DavidMS51/xmas15-project/README.md

# WordClock
Info on how I created a simple PiZero WordClock

IMPORTANT,  

The files and information here relate the to oringinal stripboard version. 
In developing the Kickstarter version a number of changes were made to IO usage and components. 
The s/w here will NOT work on the Kickstarter board correctly. 
The reverse is also true - ie the Kickstarter s/w downloads will NOT work on hardward built to the schematic in this folder

This is offered for example only, use at your own risk
