DavidMS51/xmas15-project/8x8r1.pdf

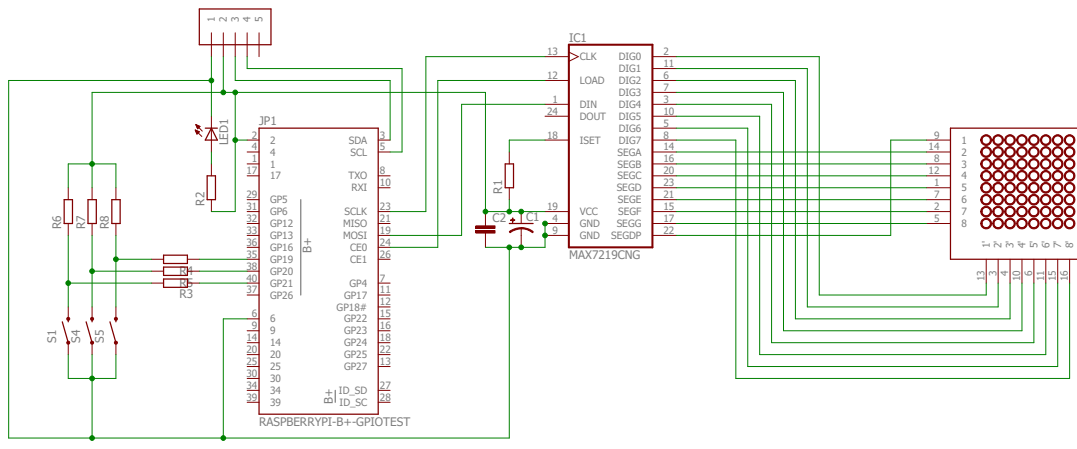
[picture p1: page 1]
MAX7219CNG; RASPBERRYPI-B+-GPIOTEST; DIG2; DIG3; DIG4; DIG5; DIG6; DIG7; SEGA; SEGB; SEGC; SEGD; SEGE; SEGF; SEGG; SEGDP; DIG1; 11 DIG0; DIN 1 DOUT 24; LOAD 12; CLK 13; ISET 18; GND 9; GND 4; VCC 19 1 1; SDA; SCL; MOSI; 19 MISO; 21 SCLK; RXI; 10 TXO; C1 R¹ R² LED¹ S1; R5 R⁶R⁷R⁸ S4S5
