DavidMS51/xmas15-project/8x8r1.sch

## EAGLE design 8x8r1.sch (2016-01-15, last stored version)

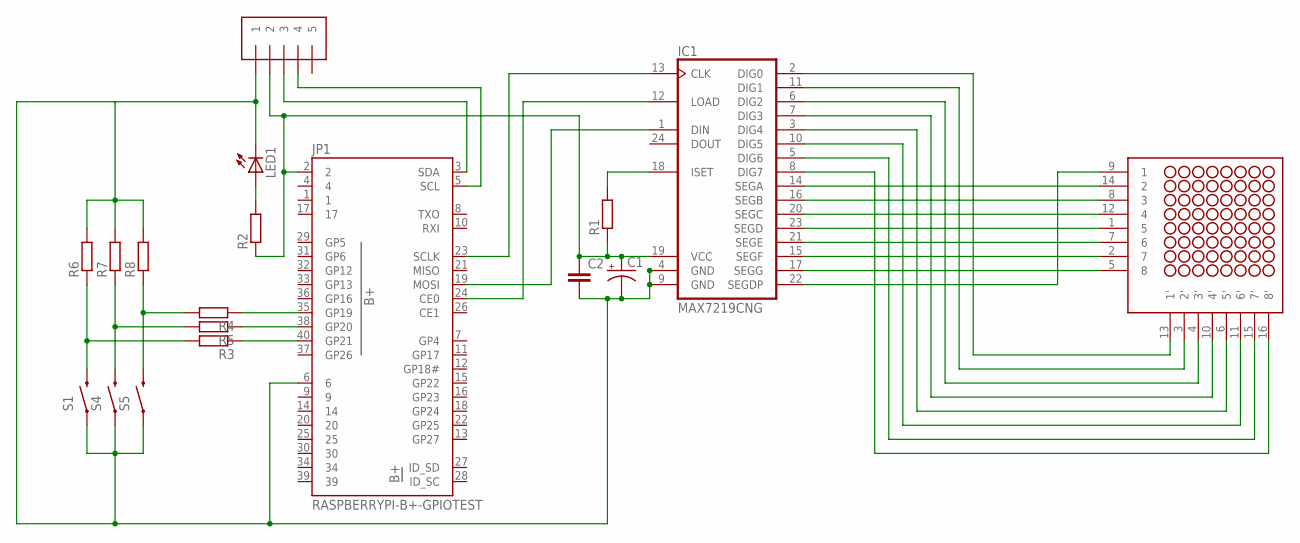
[picture p2: schematic 8x8r1.sch]

Parts:
C1: CPOL-USE2.5-7; E2,5-7
C2: C-EU025-024X044; C025-024X044
IC1: MAX7219CNG; DIL24-3
J1: 1X5; 1X05-3.5MM
JP1: RASPBERRYPI-B+-GPIOTEST; 2X20-SHROUDED
LED1: LED3MM
R1, R2, R3, R4, R5, R6, R7, R8: R-EU_0204/7; 0204/7
S1, S4, S5: SPARKFUN-ELECTROMECHANICAL_SWITCH-MOMENTARY-2PTH; SPARKFUN-ELECTROMECHANICAL_TACTILE-PTH
U$1: NFM-12881BG-11

Connections:
unnamed: IC1.2 (DIG0), U$1.13 (1')
unnamed: IC1.11 (DIG1), U$1.3 (2')
unnamed: IC1.6 (DIG2), U$1.4 (3')
unnamed: IC1.7 (DIG3), U$1.10 (4')
unnamed: IC1.3 (DIG4), U$1.6 (5')
unnamed: IC1.10 (DIG5), U$1.11 (6')
unnamed: IC1.5 (DIG6), U$1.15 (7')
unnamed: IC1.8 (DIG7), U$1.16 (8')
unnamed: IC1.17 (SEGG), U$1.5 (8)
unnamed: IC1.15 (SEGF), U$1.2 (7)
unnamed: IC1.21 (SEGE), U$1.7 (6)
unnamed: IC1.23 (SEGD), U$1.1 (5)
unnamed: IC1.20 (SEGC), U$1.12 (4)
unnamed: IC1.16 (SEGB), U$1.8 (3)
unnamed: IC1.14 (SEGA), U$1.14 (2)
unnamed: IC1.22 (SEGDP), U$1.9 (1)
unnamed: C1.+, C2.1, IC1.19 (VCC), J1.2, JP1.2, R1.1, R2.1
unnamed: IC1.18 (ISET), R1.2
unnamed: IC1.12 (LOAD), JP1.24 (CE0)
unnamed: IC1.1 (DIN), JP1.19 (MOSI)
unnamed: IC1.13 (CLK), JP1.23 (SCLK)
unnamed: LED1.A, R2.2
unnamed: JP1.35 (GP19), R4.1
unnamed: J1.3, JP1.3 (SDA)
unnamed: J1.4, JP1.5 (SCL)
unnamed: JP1.38 (GP20), R5.1
unnamed: JP1.40 (GP21), R3.1
unnamed: R4.2, R8.1, S5.3 (2)
unnamed: R5.2, R7.1, S4.3 (2)
unnamed: R3.2, R6.1, S1.3 (2)
unnamed: C1.-, C2.2, IC1.4 (GND), IC1.9 (GND), J1.1, JP1.6, LED1.K (C), R6.2, R7.2, R8.2, S1.1, S4.1, S5.1
