DavidMS51/xmas15-project/font test.docx

H | A | T | W | E | N | T | Y
F | I | F | V | T | E | E | N
L | F | * | P | A | S | T | O
N | I | N | E | I | G | H | T
O | N | E | T | H | R | E | E
T | W | E | L | E | V | E | N
F | O | U | R | F | I | V | E
S | I | X | S | E | V | E | N

H | A | T | W | E | N | T | Y
F | I | F | V | T | E | E | N
L | F | * | P | A | S | T | O
N | I | N | E | I | G | H | T
O | N | E | T | H | R | E | E
T | W | E | L | E | V | E | N
F | O | U | R | F | I | V | E
S | I | X | S | E | V | E | N

Courier New

H | A | T | W | E | N | T | Y
F | I | F | V | T | E | E | N
L | F | * | P | A | S | T | O
N | I | N | E | I | G | H | T
O | N | E | T | H | R | E | E
T | W | E | L | E | V | E | N
F | O | U | R | F | I | V | E
S | I | X | S | E | V | E | N

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

Letter Gothic

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

Consolas

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

Pragmata

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

Monaco

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

Boheman Typewriter
