DavidMS51/xmas15-project/(commit log)

2016-01-15 Initial set of basic instructions
    [8x8r1.sch]
2016-02-19 Common Anode driver
    to use this you need to change the relevant line in matrix_clockr1.py to
    point to this file rather than the cc version
2016-04-04 correction to schematic
    corrected error on switch common connection
