DavidMS51/xmas15-project/(notices)

Notices in the files:
parts and their libraries:
SparkFun-Boards: Licensing: Creative Commons ShareAlike 4.0 International - https://creativecommons.org/licenses/by-sa/4.0
eagle-library-edeca.net-v5: This is v1 and is licensed under the Creative Commons (Attribution-Non-Commercial-Share Alike 2.0 UK)
